delaitl/Synthetizer---Circuit-Architecture/Rapport.pdf

# LELEC1101 Rapport Final Synthétiseur - Casque Anti-Bruit

Groupe 31 - Delait L, Delcoigne B, Dufromont C, Letor M.

Mai 2019

## Contents

1 Introduction | 4
2 Vue d’ensemble du circuit | 4
3 Spécifications | 5
I | Synthétiseur | 5
4 Clavier | 5
4.3 Equations et dimensionnement | ´ | 6
4.4.2 | Equation | ´ | 7
5 Oscillateur contrôlé en tension (OCT) | 8
6 Conformateur à diodes | 13
6.3 Equations | ´ | 14
II | Noise-cancelling | 16
7 Introduction | 16
8 Micro filtre passe-haut | 17
9 Amplificateur variable | 17
9.2 Equations | ´ | 18
10 Filtre passe-tout | 18

11 Sommateur | 21
12 Suiveur | 22
III | Conclusion | 22
IV | Annexe | 24

## 1 Introduction

Dans le cadre du cours LELEC1101, les étudiants de deuscième bachelier en ingénieur civil ont été conviés à concevoir un synthétiseur et une unité d’annulation de bruit. L’Université Catholique de Louvain a mis les composants électroniques nécessaires à leur disposition. Notamment des résistances, capacités, amplificateurs opérationnels, comparateurs et des switches. Aucun autre composant n’était autorisé.
Le synthétiseur doit produire des sons correspondant à des notes de musique lors d’un appui sur ses touches. Dans notre implémentation, il est constitué d’un clavier, d’un oscillateur contrôlé en tension et d’un lisseur de signal. Le casque anti-bruit doit annuler les bruits parasites extérieurs. Il est constitué d’un micro, d’un filtre, d’un amplificateur et d’une unité de déphasage. Les deux signaux de sortie des deux unités doivent ensuite être additionnés pour alimenter le casque audio. Le produit final de notre projet est assez fidèle aux objectifs fixés. Le synthétiseur reproduit toutes les notes de deux octaves (LA3 → LA5) avec une imprécision moyenne de 4 Hz (0.5%) et maximum de 10Hz (1%). L’unité anti-bruit fonctionne comme attendu théoriquement: tous les signaux sont d’amplitude et de déphasage attendu. En pratique, lorsque le casque est branché, il est toutefois très difficile d’entendre une atténuation du bruit. Cela est dû à la difficulté de calibrage de l’implémentation.

## 2 Vue d’ensemble du circuit

La Figure 1 présente la décomposition en schémas blocs globalle. Le circuit est divisé en deux sous-circuits. Le premier se charge de la fonction synthétiseur alors que le second se charge de la réduction de bruit. Le synthétiseur est constitué d’un ensemble de boutons qui produisent un signal à tension continue. Ce dernier alimente un oscillateur contrôlé en tension (OCT) qui produit un signal triangulaire dont la fréquence dépend linéairement de la tension d’entrée. Le signal triangulaire est ensuite transformé en pseudo-sinusoïde afin de produire un son. L’unité anti-bruit est constituée d’un microphone dont le signal est d’abord filtré et amplifié. Ce filtrage est nécessaire car une composante continue est présente dans le signal capté par le microphone. Le signal filtré est enfin déphasé. Le déphasage est indispensable pour compenser le temps pris par le trajet du son sur la distance oreille-microphone. Les deux signaux sont ensuite additionnés et envoyés dans un casque audio.

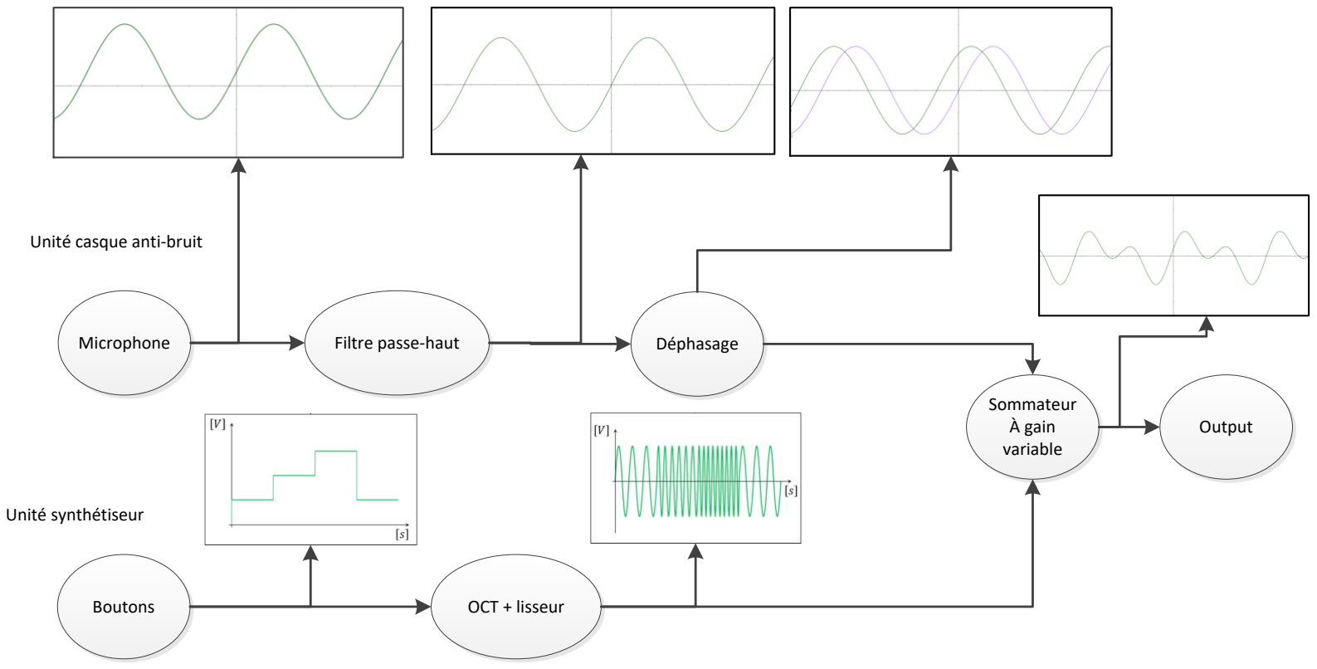
[picture p1: figure]
Microphone; Filtre passe-haut; Déphasage; Boutons; OCT + lisseur; Sommateur À gain variable; Output; Unité casque anti-bruit; Unité synthétiseur

Figure 1: Schéma bloc global du circuit

## 3 Spécifications

Contraintes
| Tensions d’alimentation de + et - 15V
| perturbation monochromatique
Choix synthétiseur
Nombre d’octaves couvertes | 2 (La 3 (440Hz) - La5 (1760 Hz))

2V
Effets sonores | Aucun
Pureté des notes | δfmoyen de 4 Hz (0.5%) δfmax de 10 Hz (1%)

Choix casque anti-bruit
Fréquence à laquelle l’annulation est maximale | 1000 Hz
Taux de réduction | indéterminé
Fonction du synthétiseur | f =

440
1.5

Vin heightAmplitude du son

## Part I

# Synthétiseur

Cette partie expose en détail l’implémentation choisie pour le synthétiseur. Il est composé d’un clavier qui prend pour entrée une tension continue et sort une tension différente selon la combinaison de touches pressées. Ce signal est introduit dans un oscillateur commandé en tension (OCT) produisant un signal triangulaire périodique de fréquence linéairement proportionnelle à la tension d’entrée. Le signal triangulaire est lissé par un conformateur à diodes qui le convertit en signal pseudo-sinusoïdal.

## 4 Clavier

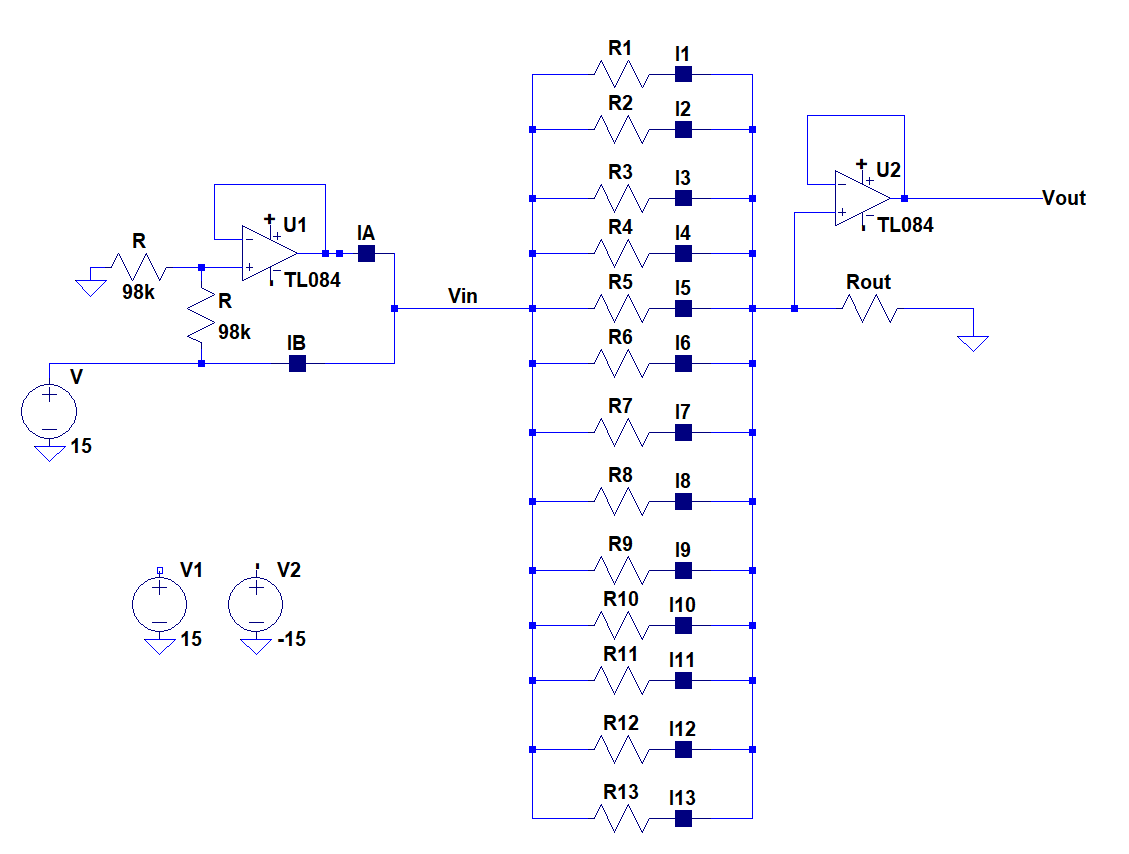
[picture p2: figure]

Figure 2: Montage Clavier - Ii est ici le diminutif de l’Interrupteur i

### 4.1 Description

Le clavier permet, selon la combinaison d’interrupteurs fermés, de produire une tension Vout allant de 1.5 à 3 V et de 3 à 6 V. Comme décrit sur la Figure 1, ce signal en tension continue alimente ensuite l’oscillateur contrôlé en tension qui produit un signal dont la fréquence lui est directement proportionnelle.

### 4.2 Fonctionnement

Le clavier fonctionne sur base d’un double diviseur résistif : le premier permet d’avoir une tension d’entrée (Vin) de 7.5V ou 15V (selon si IA ou IB est fermé) et le second permet de modifier la valeur des résistances Ri
, et donc
la tension Vout (en fermant un des interrupteurs Ii), i ∈ [1, 13].

### 4.3 Equations et dimensionnement ´

Sur base du dimensionnement de l’OCT, la tension minimale Vout doit être de 1.5V et correspondre à un LA3 (440Hz). La relation tension-fréquence étant linéaire, LA4 (880Hz) ↔ 3V et LA5 (1760Hz) ↔ 6V.
La tension de sortie du clavier (Vout) ne dépasse pas 6V pour être sûr de rester dans la zone de comportement idéal de l’ampli op.
25 notes doivent pouvoir être jouées par le synthétiseur et donc 25 tensions produites en Vout.
Ce bloc étant un diviseur résistif (avec 2 montages suiveurs dont la présence sera justifiée par la suite), l’équation qui le caractérise est la suivante :

Vout =

Vin(IA, IB) · Rout

Ri(Ii) + Rout

(1)

Avec i ∈ [1, 13].

On peut donc jouer sur 2 paramètres d’un côté et 13 de l’autre ce qui fait 26 tensions en Vout possibles et donc 26 notes potentielles.
Le synthétiseur doit être capable de produire 25 notes du LA3 au LA5 selon nos spécifications. Sur base de la relation LA4 (880Hz) ↔ 3V et en sachant que la relation Vout-fréquence est linéaire, connaissant les fréquences voulues, on peut déterminer les tensions Vout en sortie du clavier.

Le LA4 peut être joué de 2 manières différentes par les combinaisons (iA, i13) ou (iB, i1) qui produisent toutes les 2 une tension de 5V:
De là, connaissant Vout, il ne reste qu’à déterminer les valeurs des résistances Rout et Ri
La valeur de Rout a été imposée à 362Ω, et de là se calculent les valeurs de la Figure 3

Figure 3: Tableau valeurs résistances

Finalement, la Figure 4 donne la tension Vout à la sortie du clavier ainsi que la note correspondante à la sortie de l’OCT selon la combinaison d’interrupteurs actionnés.

### 4.4 Les deux montages suiveurs

### 4.4.1 Description et Fonction

L’introduction d’un montage suiveur U1 se justifie par le fait qu’un simple diviseur de tension provoque une chute de tension en Vin lorsqu’on active un des interrupteurs Ii

, le courant étant trop faible pour maintenir la tension à 7.5V.
De la même façon, le montage suiveur U2 fut implémenté car le courant en sortie du clavier est trop faible en entrant dans l’OCT, une chute de tension apparaissant à cet endroit.

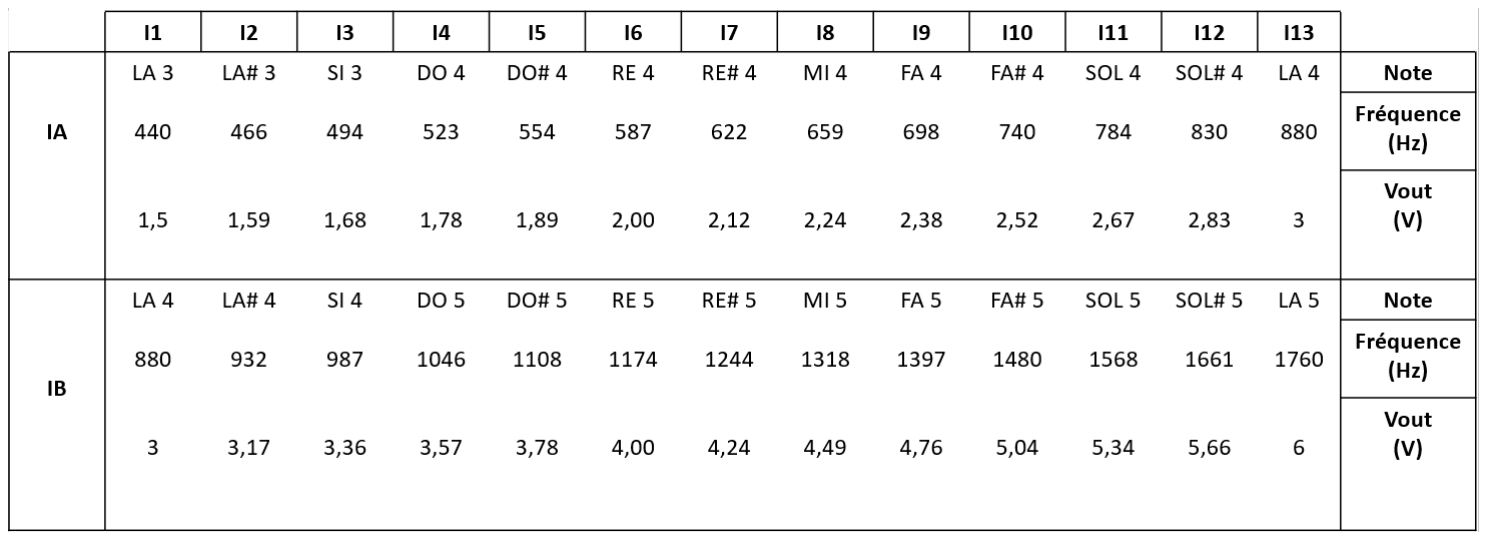
[picture p3: figure]

Figure 4: Tableau interrupteurs-tension-note

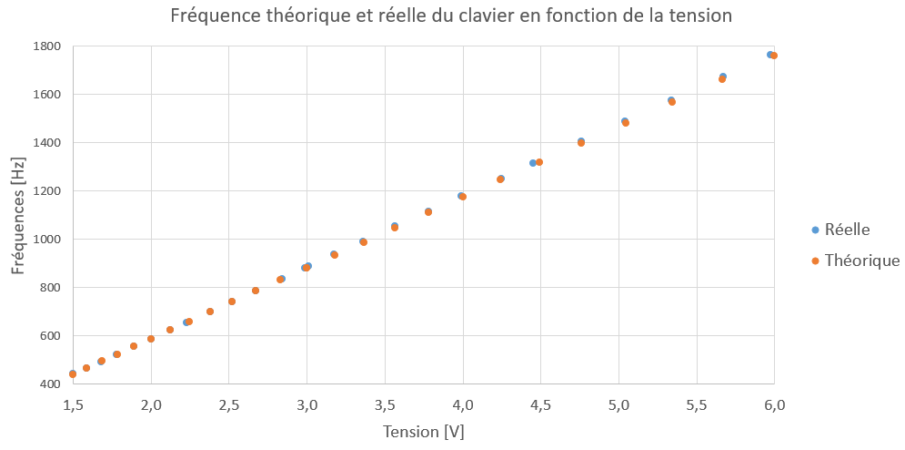
[picture p4: figure]

Figure 5: Graphe fréquence-tension

### 4.4.2 Equation ´

Dans la zone de comportement idéal de l’ampli op l’équation qui les caractérise est :

Vout = Vin

### 4.5 Résultats expérimentaux et comparaison

On observe sur la Figure 5 un léger décalage entre les fréquences souhaitées et les fréquences réellement obtenues (δfmax de 10Hz, δfmoyen de 3.5Hz). Cette différence peut être expliquée car les tensions en sortie de l’OCT ne sont pas parfaitement égales aux valeurs souhaitées(δVmax de 43mV, δVmoyen de 7mV).
Cette différence minime de tension peut elle-même s’expliquer par le fait qu’il y ait une différence entre les valeurs des résistances voulues et les valeurs réelles du circuit (δRmax de 14 Ω, δRmoyen de 5 Ω).
Toutes les résistances sont des potentiomètres qu’il a fallu régler manuellement, les valeurs de résistances nécessaires n’étant évidemment pas disponibles telles quelles, de par leur valeur très spécifique. Les erreurs sont donc causées par le degré de précision mécanique des potentiomètres.
Toutes les valeurs des mesures sont disponibles en Annexe.

### 4.6 Pistes d’amélioration

Il serait opportun d’imaginer un troisième interrupteur IC en lien avec la source et un diviseur de tension tel que Vin = 0.75V . De fait, et par le même raisonnement qu’explicité ci-dessus, on pourrait couvrir les notes du LA2 au LA3 et ainsi de suite avec un quatrième interrupteur tel que Vin = 0.375V . Cela nécessiterait des valeurs de plus en plus précises pour les résistances utilisées (et donc des imprécisions grandissantes) et permettrait de couvrir toutes les notes plus basses que LA3.

## 5 Oscillateur contrôlé en tension (OCT)

### 5.1 Fonctionnement et description

L’oscillateur commandé en tension se base sur un principe de rétroaction. La spécification donnée est qu’une tension continue est donnée en entrée afin de générer un signal triangulaire périodique. Le système conçu est le suivant: soit la tension continue entre telle quelle dans le circuit, soit elle est inversée. Ce signal continu positif ou négatif entre dans un montage ampli-op intégrateur produisant une pente montante, ou descendante. Ce signal linéaire croissant ou décroissant commande une bascule à hystérèse qui active un interrupteur lorsque la tension atteint un certain seuil, et le désactive seulement lorsqu’un autre seuil est atteint. Cet interrupteur a un effet sur la tension d’entrée qui est inversée ou non. Un signal triangulaire apparaît en coordonnant correctement ces trois éléments.

### 5.2 Décomposition par blocs

Cette section détaille chaque bloc composant l’oscillateur contrôlé en tension. Les variables utilisées, ainsi que le circuit implémenté se trouvant en Figure 6.

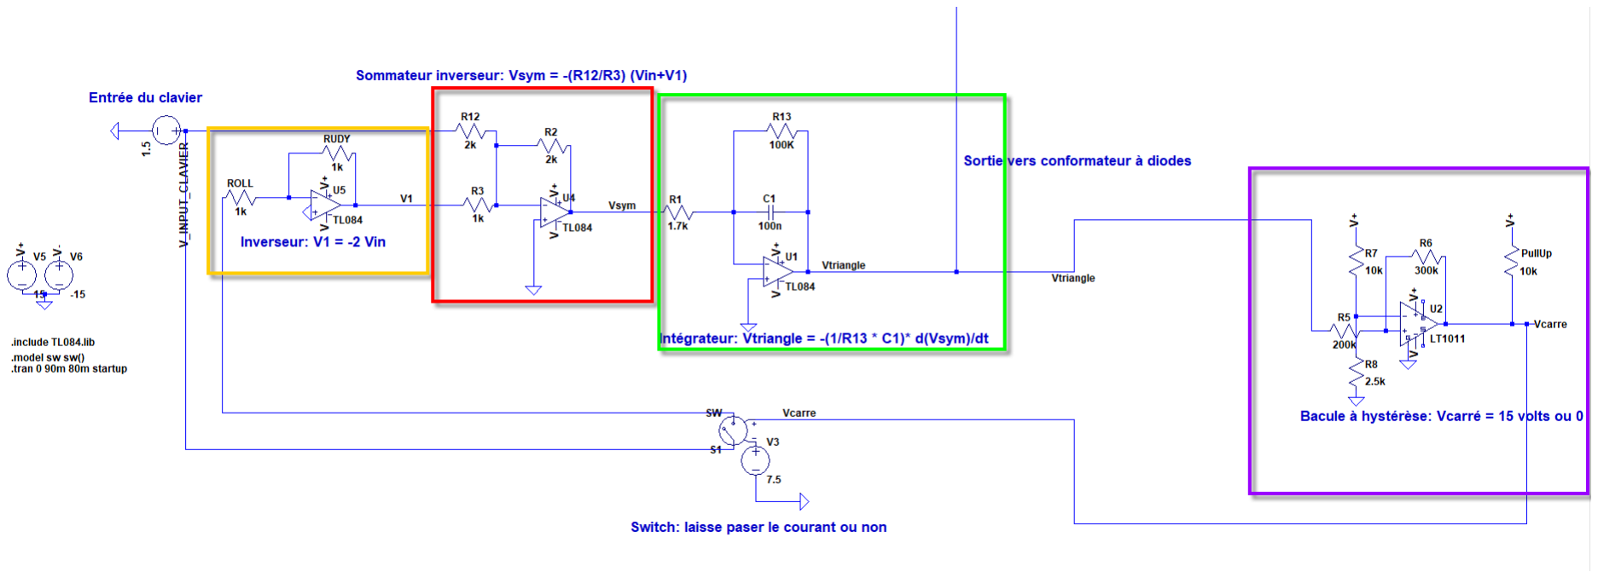
[picture p5: figure]

Figure 6: Circuit de l’oscillateur controlé en tension

### 5.2.1 Inverseur

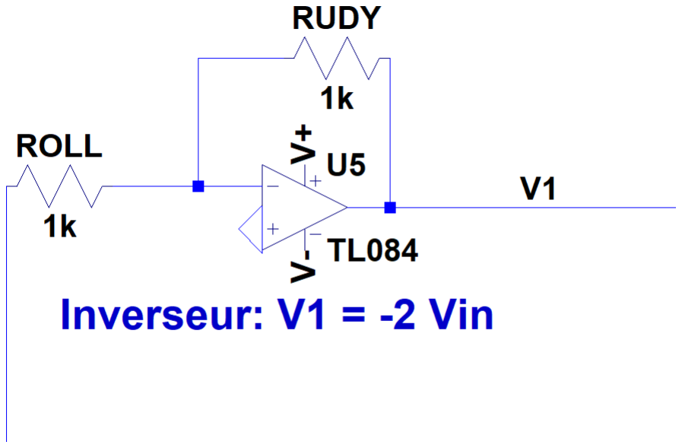
[picture p6: figure]

Figure 7: Schéma de l’inverseur

Description La Figure 7 présente le schéma de l’inverseur. L’inverseur prend pour tension d’entrée la tension sortant du clavier, ou bien une tension nulle, dépendant de l’état du switch. L’objectif est d’en ressortir la tension inverse.

Equations Par la loi des noeuds,

V1 = −(

Rudy
Roll ) · Vin | (2)

Choix des composants L’objectif du bloc est d’obtenir une tension de sortie

V1 = −Vin

Vin. Le rapport des résistances Rudy
Roll doit donc être unitaire. Nous avons choisi des résistances de même valeur.

### 5.2.2 Sommateur inverseur

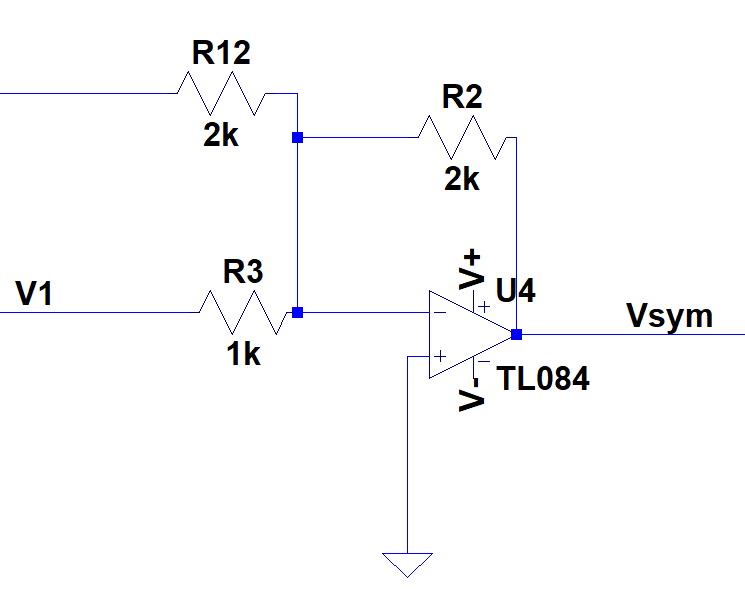
[picture p7: figure]

Figure 8: Schéma de sommateur inverseur

Description La Figure 8 présente le schéma du bloc sommateur. Le sommateur prend pour tension d’entrée la tension générée par le clavier, ainsi que la tension sortant de l’inverseur. L’objectif visé est d’obtenir selon l’état d’un switch la tension d’entrée du clavier, ou son inverse. Cet objectif est atteint facilement avec un sommateur inverseur qui somme soit uniquement le signal sortant du clavier, soit le signal du clavier additionné de son inverse avec un rapport de 2.

Equations ´ | Par Kirchhoff:
Vsym = −R2( Vin
R12

+

V 1
R3
) | (3)

Choix des composants Lorsque le switch laisse passer le courant, le sommateur inverseur reçoit deux entrées: Vin et V 1. L’objectif est d’obtenir Vin en sortie. Par la relation 3, Vsym = Vin si R2 = R12 et 2 R3 = R2. Lorsque le switch ne laisse pas passer le courant, le sommateur inverseur inverse uniquement Vin avec un rapport unitaire. Selon l’état du switch, la sortie est bien la tension d’entrée inversée ou non.

### 5.2.3 Intégrateur

Description La Figure 9 présente le schéma de l’intégrateur à perte.L’objectif du bloc intégrateur est d’obtenir en sortie un signal triangulaire symétrique. En intégrant une tension continue positive, on obtient une tension linéairement croissante en sortie. Pour une tension d’entrée négative, la sortie est décroissante. La tension d’entrée est positive ou négative suivant l’état du switch. Cette sortie sera symétrique uniquement si la période durant laquelle la pente est décroissante est aussi longue que lorsqu’elle est croissante. Autrement dit, si la tension d’entrée est positive durant un laps de temps, elle doit être négative durant le même laps de temps. La bascule à hystérèse a pour rôle d’actionner le switch au bon moment pour coordonner cette tâche.

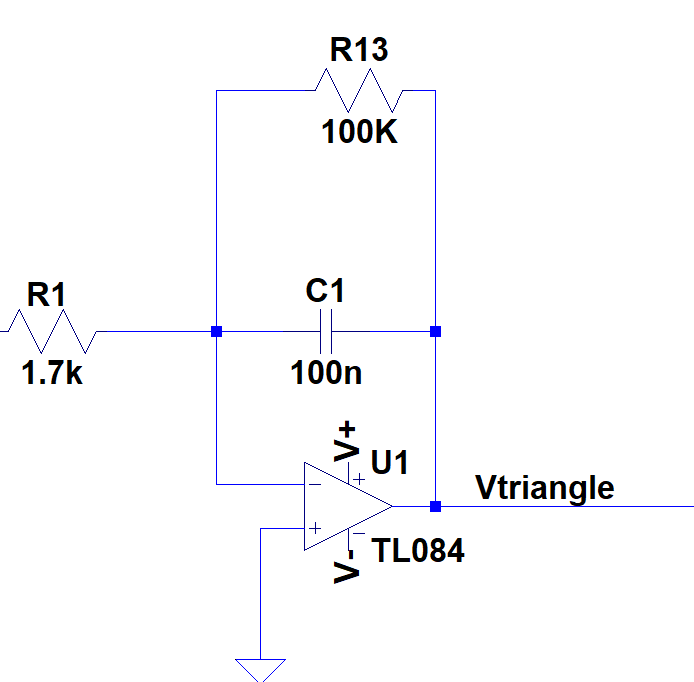
[picture p8: figure]

Figure 9: Schéma de l’intégrateur

Equations ´ | La tension de sortie de l’intégrateur peut à nouveau être exprimée par la loi des noeuds:

Vtriangle =

−1
R13 · C1

Z
Vsymdt | (4)

Le gain est donné par
−R1
R13

(

1
1 + R13jωC1
) | (5)

La fréquence de coupure est donnée par 1
2πR13C1

(6)

Choix des composants Le choix de la résistance et de la capacité influence directement sur la fréquence de l’OCT.
Il est donc primordial d’exprimer la fréquence en fonction de la tension d’entrée.

L’équation 4 de l’intégrateur nous permet de calculer la pente du signal triangulaire:

dVtriangle
dt =

−1
R13 · C1
Vsym | (7)

Le bloc suivant, la bascule à hystérèse, fait en sorte que le signal triangulaire reste borné entre la tension de bascule haute et basse. Cela signifie que sur une demi-période, la tension passe linéairement du seuil haut au seuil bas. Seuil haut étant fixé à 5V, et bas à -5V. Sur une demi-période, le delta de tension est de 10V

2 · 10V
T

(8)

En combinant les équations (7) et (8), 1
T

=

Vsym
20 · R13 · C1

(9)

Avant de déterminer R et C, il est impératif d’associer une tension à une fréquence. Nous avons choisi une fréquence de 440Hz lorsque Vin= 1.5V. Comme la fréquence dépend linéairement de la tension d’entrée (9), à 3V nous aurons 880Hz, et à 6V 1760Hz. Avec l’équation 9, en remplaçant la fréquence par 440Hz et la tension par 1.5V, nous trouvons
R13 · C1 = 1.704 · 10⁻⁴

Une capacité de 100nF a été choisie, ainsi qu’un potentiomètre de 2kΩ réglé à 1.7 kΩ La résistance R13 a été choisie telle que la fréquence de coupure soit d’environ 20Hz afin de se situer dans le comportement intégrateur (voir Figure
10) de l’ampli-op dans nos fréquences générées. Une résistance de 100K donne une fréquence de coupure de 16Hz par l’équation (6). C’est bien ce qu’on peut observer dans le Figure 10.

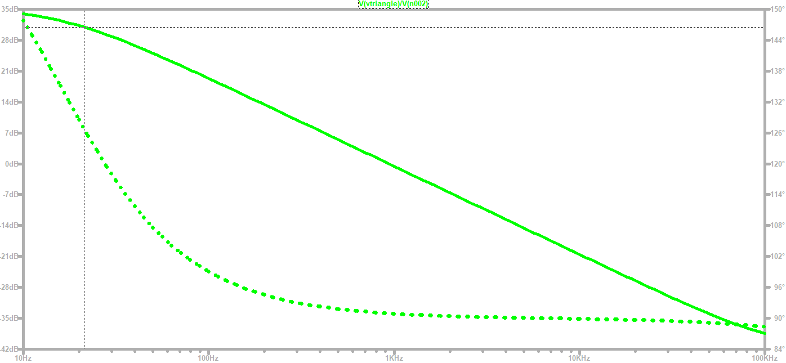
[picture p9: figure]

Figure 10: Diagramme de bode de l’intégrateur (simulation)

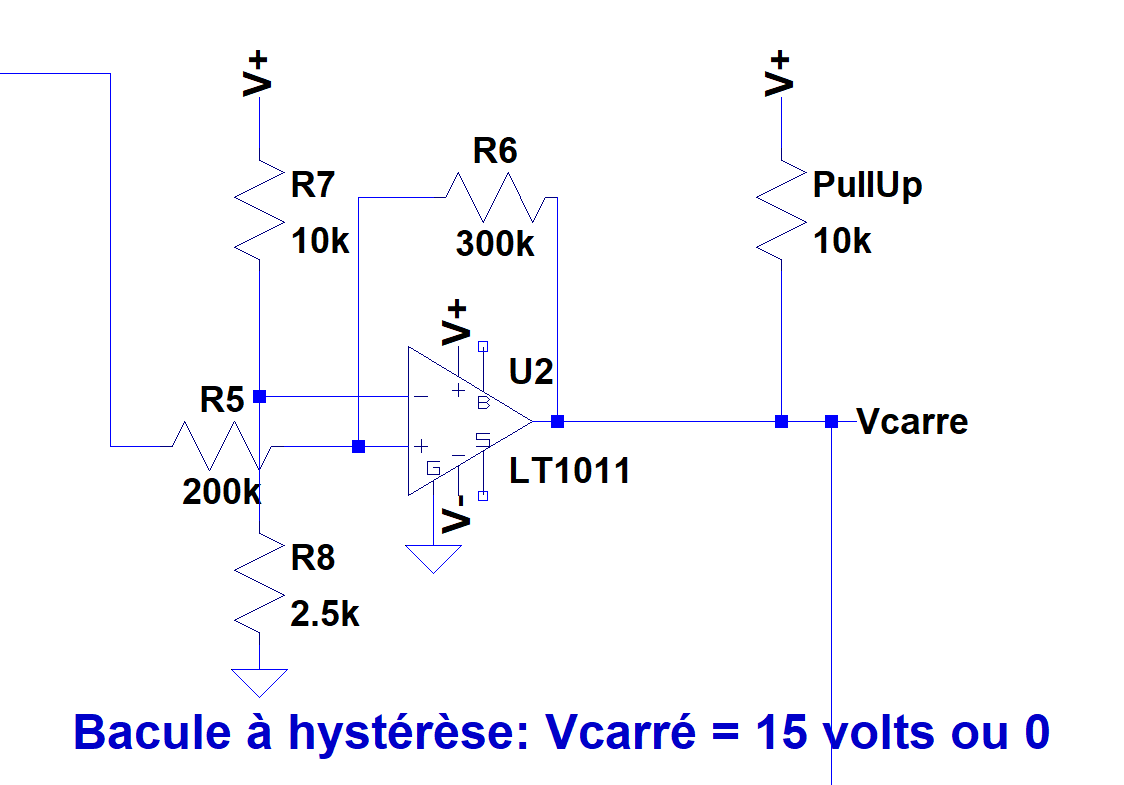
[picture p10: figure]

Figure 11: Schéma de la bascule à hystérèse

### 5.2.4 Bascule à hystérèse

Description La Figure 11 présente le schéma de la bascule à hystérèse. Le rôle de la bascule à hystérèse est d’actionner l’interrupteur de rétroaction au bon moment (voir intégrateur). L’interrupteur est commandé en tension: il s’ouvre lorsqu’une tension de 15V lui est donnée en entrée, et se ferme avec une tension nulle. Par conséquent, la spécification donnée au bloc bascule à hystérèse est de générer une tension continue de 15V lorsqu’un seuil haut a été atteint, et une tension nulle lorsqu’un seuil bas a été atteint. Les seuils haut et bas ont été fixés à +5V et -5V. Il est impératif que la valeur absolue des seuils soit identique afin d’avoir un signal triangulaire symétrique.
Le signal sortant de l’intégrateur entre dans la bascule à hystérèse. Initialement, ce signal est décroissant. Lorsque le seuil de -5V est atteint, la bascule actionne le switch, ce qui a pour effet d’inverser la tension entrante dans l’intégrateur et par conséquent de produire un signal linéaire croissant. Lorsque ce signal atteint le seuil de 5V, le switch change à nouveau d’état et donc le signal décroît à nouveau. Ce mécanisme nous fournit donc un signal triangulaire périodique.

Equations Les équations (10) et (11) donnent les valeurs des seuils haut et bas de la bascule à hystérèse. Vref est la tension à la borne négative de l’amplificateur opérationnel. Nous pouvons la fixer avec le pont résistif formé de R7 et R8.
Vh = VREF · (1 + R5
R6
) | (10)

Vb = VREF +

R5
R6
- (Vref − VDD) | (11)

La spécification du bloc est que le seuil haut, Vh soit égal à 5V, et Vb à -5V. En résolvant le système d’équations, sachant que VDD = 15V, nous trouvons:

Vref = 3V

R6
R5

=

3
2

Choix des composants VRef est générée par un simple diviseur résistif constitué d’un potentiomètre de 10kΩ. Pour effectuer nos calculs nous avons utilisé la condition de simplification: 1kΩ < Rpullup << R6. Rpullup, la résistance pullup est une résistance de 10kΩ. R6 doit donc lui être bien supérieure. Pour le rapport R5/R6, un potentiomètre de 400kΩ a donc été choisi.

### 5.3 Comparaison

Afin de vérifier la cohérence des calculs et simulation, il est important de comparer les signaux obtenus aux différents endroits de l’OCT. Cette section reprend les signaux d’entrée et de sortie de chaque bloc, en simulation et en réalité.

Sortie du sommateur Selon les équations, la sortie du sommateur présente un signal périodique carré symétrique. Avec une tension haute égale à l’inverse de la tension basse. La Figure 12 montre la tension en sortie du sommateur dans nos simulations LTSPICE, alors que la Figure 13 montre la tension dans le circuit implémenté. Les signaux simulés sont symétriques comme prévu par les équations. Les signaux réels semblent être symétriques aussi. L’erreur est trop petite pour être mesurée.

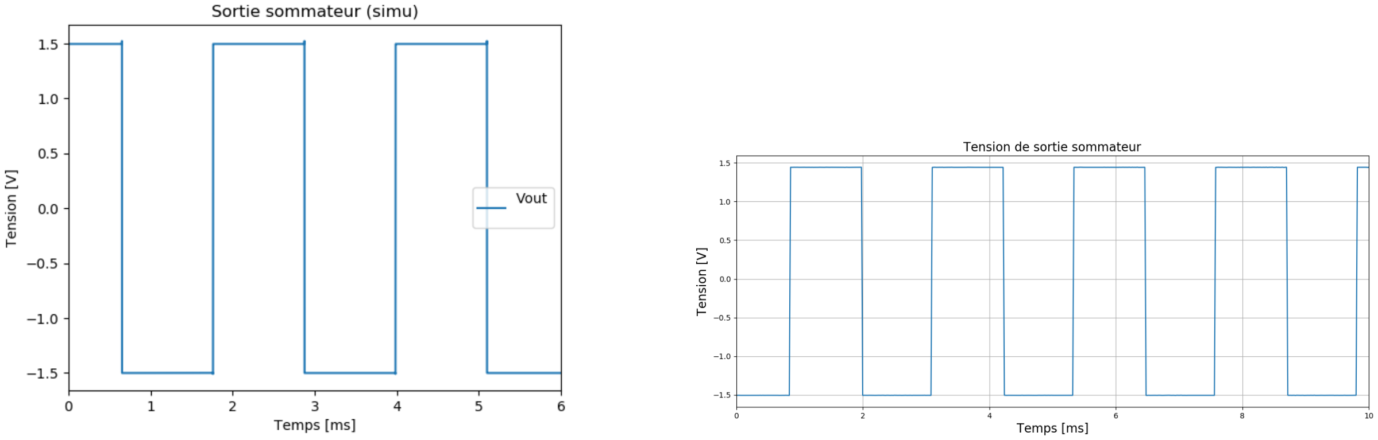
[picture p11: figure]

Figure 12: Signal en sortie sdu sommateur(simulation)

Figure 13: Sortie du sommateur inverseur(MyDaq)

Sortie de l’intégrateur Le signal triangulaire sortant de l’intégrateur doit en théorie être borné entre -5 et 5V. Cela se justifie par le fait que la bascule à hystérèse agit théoriquement à -5V et 5V pour inverser la pente de l’intégrale. La Figure 14 montre le signal simulé sortant de l’intégrateur et la Figure 15 montre ce même signal dans le circuit implémenté. En simulation comme en réalité, la tension d’entrée est de 1.5V, ce qui correspond théoriquement à une fréquence de 440Hz, donc une période de 2.2ms. C’est bien ce qu’on peut observer sur les deux figures.

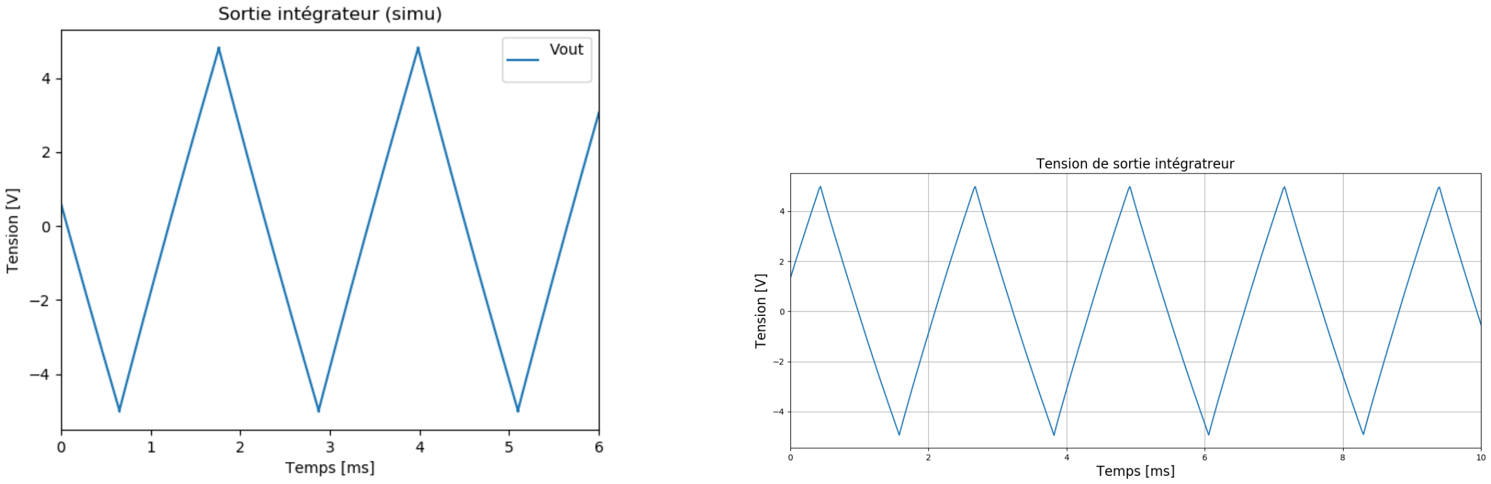
[picture p12: figure]

Figure 14: Signal en sortie de l’intégrateur (simulation)

Figure 15: Signal en sortie de l’intégrateur(MyDaq)

Bascule à hystérèse Le paramètre important à analyser dans la bascule à hystérèse est la tension seuil. La Figure 16 montre en simulation le signal entrant et sortant de la bascule. Nous observons bien que la bascule s’actionne à -5 et 5V en simulation. Malheureusement, le MyDaq ne nous permet pas de faire un graphe de la tension de la bascule. En effet, la tension varie entre 0 et 15V alors que le MyDaq sature à 10.66V. A l’oscilloscope ` nous avons remarqué que le signal, quelle que soit la fréquence, a une amplitude de 15V.

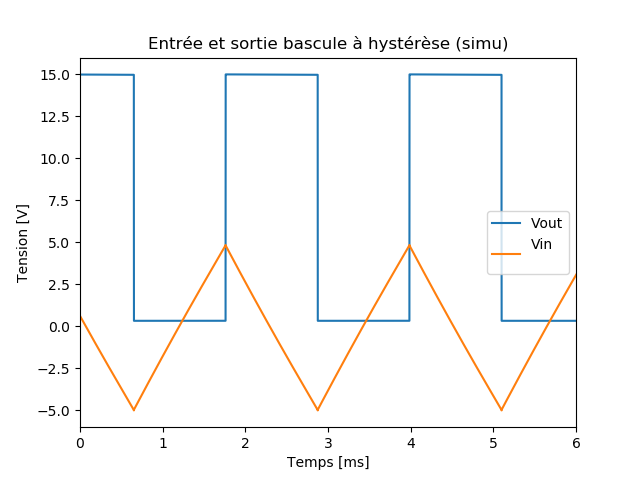
[picture p13: figure]

Figure 16: Signal entrant et sortant de la bascule à hystérèse (simulation)

## 6 Conformateur à diodes

### 6.1 Description

Ce bloc prend en entrée le signal triangle de l’intégrateur et l’interpole en un sinus plus doux à l’oreille. Le choix du conformateur à diodes pour effectuer cette tâche se justifie pour plusieurs raisons. Les fréquences auxquelles nous travaillons varient entre 440 Hz et 1760 Hz or le conformateur est insensible à la fréquence. Cependant il requiert une amplitude constante ce qui est bien notre cas (5 V).

### 6.2 Fonctionnement

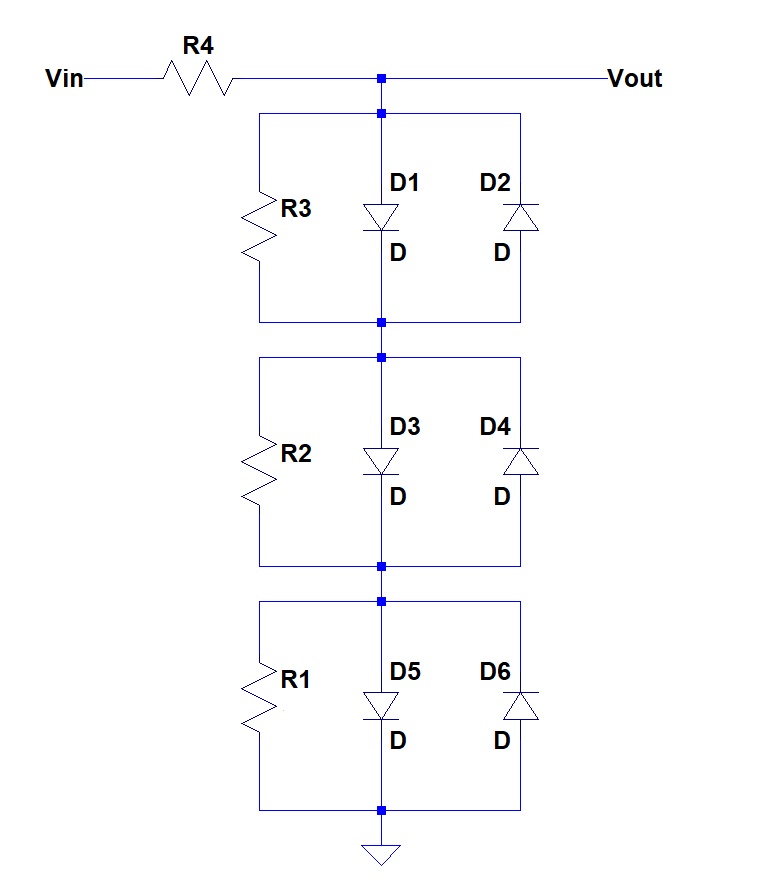
[picture p14: figure]

Figure 17: Schéma du conformateur à diodes

Le conformateur fonctionne comme un diviseur résistif qui change de valeur en fonction de la tension d’entrée (Figure 17). Ce système se base sur la non-idéalité des diodes qui ne s’activent qu’à partir de 0.6 V. Le sinus est donc interpolé en segments de droites comme montré sur la Figure 18.

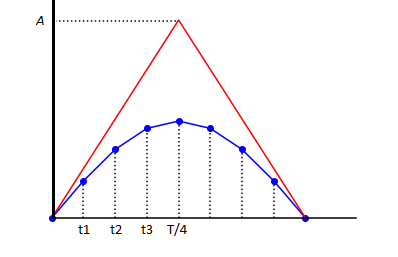
[picture p15: figure]

Figure 18: Fonctionnement du conformateur à diodes

### 6.3 Equations ´

La tension de sortie du conformateur varie en fonction du nombre de diodes passantes. Ainsi, lorsqu’aucune diode ne laisse passer le courant(entre 0 et t1), le conformateur agit comme un diviseur de tension entre R4 et les autres résistances. De ce fait la tension de sortie s’exprime:

Vs =

R1 + R2 + R3
R1 + R2 + R3 + R4

Ve

A l’instant ` | t1,la diode D5 devient passante,ce qui signifie que la tension aux bornes du premier étage (qui est égale
à la tension aux bornes de R1) vaut 0.6 V:
| Ve(t1).R1 (R1 + R2 + R3 + R4) = 0.6V

Une fois que les diodes sont passantes, elles se comportent comme des sources de tension DC de 0.6 V. Nous pouvons donc trouver trois autres équations décrivant le conformateur en fonction de la tension d’entrée:
| Entre t1 et t2: Vs(t) = 0.6 + (Ve(t) − 0.6).(R2 + R3) R2 + R3 + R4

Entre t2 et t3:
| Vs(t) = 1.2 + (Ve(t) − 1.2).R3 R3 + R4

Entre t3 et T /4:
| Vs(t) = 1.8 + Ve(t) − 1.8 R4

Les tensions négatives sont obtenues de la même façon avec les diodes disposées dans l’autre sens.

### 6.4 Choix des composants

Le choix des résistances s’effectue en fait en fonction du choix des abscisses où sera interpolé le sinus. Ce choix d’abscisses doit en effet permettre de minimiser les contributions des harmoniques dans le signal pour avoir un sinus le plus pur possible.
| Nous avons décidé de prendre des intervalles proportionnels à la pente du sinus, et non équidistants car le sinus
est assez linéaire au début puis devient de plus en plus courbe.
| Prenons un sinus d’amplitude 1 et de période 2π (cela simplifie les calculs mais ne change pas les résultats)
et calculons les fractions de période. Nous savons que la pente de sin(t) est décrite par cos(t) et qu’elle varie de 1 à 0 entre 0 et T/4(=π/2 ici). Nous séparons donc l’intervalle de pente en 4 et égalons ces temps aux pentes correspondantes:
| (cos(0) = 1), cos(x1) = 0.75, cos(x2) = 0.5, cos(x3) = 0.25 Ce qui nous donne nos abscisses qu’il faut encore diviser par 2π afin d’obtenir des fractions de période. On

obtient t1 ' 0.115T, t2 = T /6 ' 0.167T et t3 ' 0.21T.Le sinus interpolé avec de telles abscisses est représenté à la figure 19.
| Une fois ces abscisses calculées, les résistances découlent des équations aux différents points d’interpolation à
savoir:

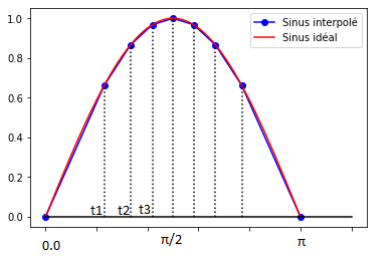
[picture p16: figure]

Figure 19: Sinus interpolé aux abscisses optimisées

En t1:
0.6 =

Ve(t1).R1
R1 + R2 + R3 + R4
En t2:
0.6 =

(Ve(t2) − 0, 6).R2
R2 + R3 + R4
En t3:
0.6 =

(Ve(t3) − 1, 2).R3
R3 + R4
Nous disposons donc de 3 équations à 4 inconnues. Nous avons décidé arbitrairement de fixer R4 à 1.8 kΩ. En résolvant ensuite le système et en tenant compte que le signal triangle d’entrée varie entre -5v et 5V, nous obtenons R1 = 450 Ω, R2=633Ω et R3=1 017Ω.

### 6.5 Comparaison

La théorie nous dit que le sinus sera interpolé en segments de droite. Cependant, les diodes ne sont pas idéales et les points anguleux sont lissés. Ce comportement est pris en compte par LTSpice dans les simulations. La comparaison entre la simulation et les valeurs observées au MyDaq peut être observée aux Figures 20) et 21. On peut voir que les graphes sont très similaires au niveau de la forme et donc que les simulations se rapprochent très bien de la réalité.

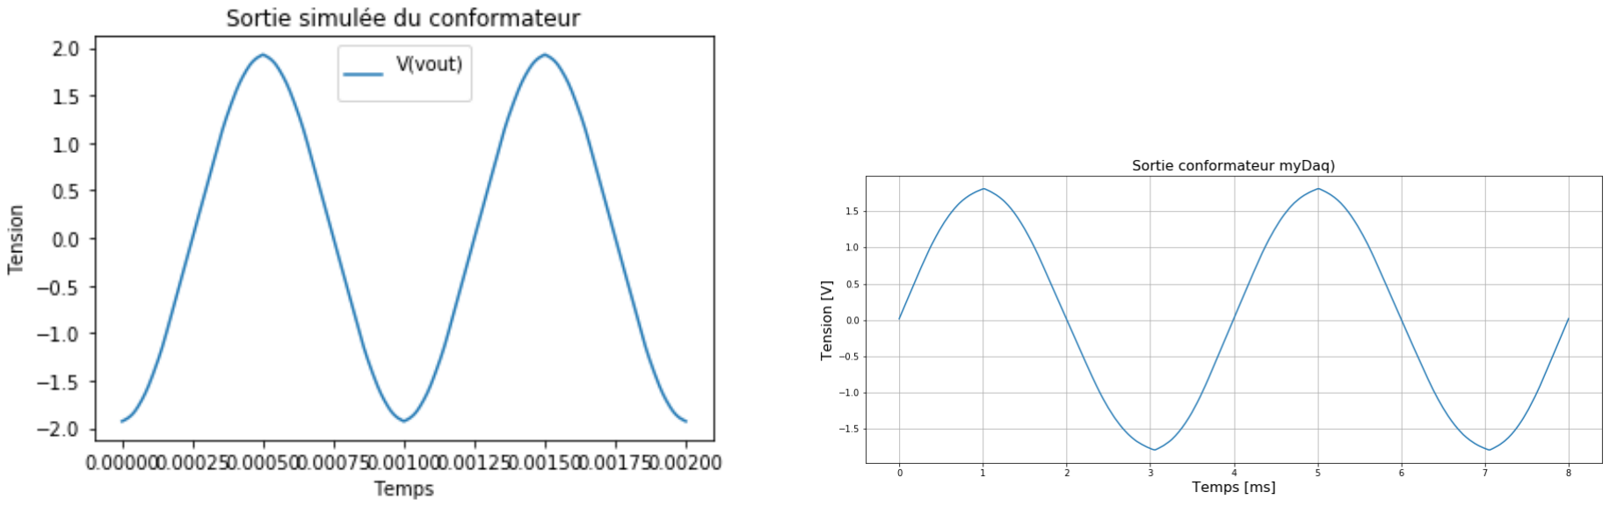
[picture p17: figure]

Figure 20: Sortie du conformateur sur LT-Spice

Figure 21: Sortie du conformateur au MyDaq

De plus, les simulations montraient que le conformateur interpolait le sinus de la même manière quelle que soit la fréquence. Des tests au laboratoire nous ont confirmé ce comportement, nous n’avons donc pas à nous soucier d’une éventuelle déformation quelle que soit la note jouée.

### 6.6 Résultat

La qualité d’un sinus s’observe en consultant son contenu spectral. Sur le spectre obtenu en simulation (Figure 22 à 1000 Hz), nous pouvons voir la fondamentale à 1kHz ainsi que la première harmonique à 3kHz qui est déjà très atténuée(-32dB). Toutes les harmoniques suivantes sont atténuées en deçà de cette valeur. Le spectre obtenu en laboratoire est similaire bien que l’on puisse constater une moindre atténuation des harmoniques. Cela peut s’expliquer par le fait que les résistances calculées ont des valeurs spécifiques que nous avons réalisées avec des potentiomètres moins précis que dans la simulation.

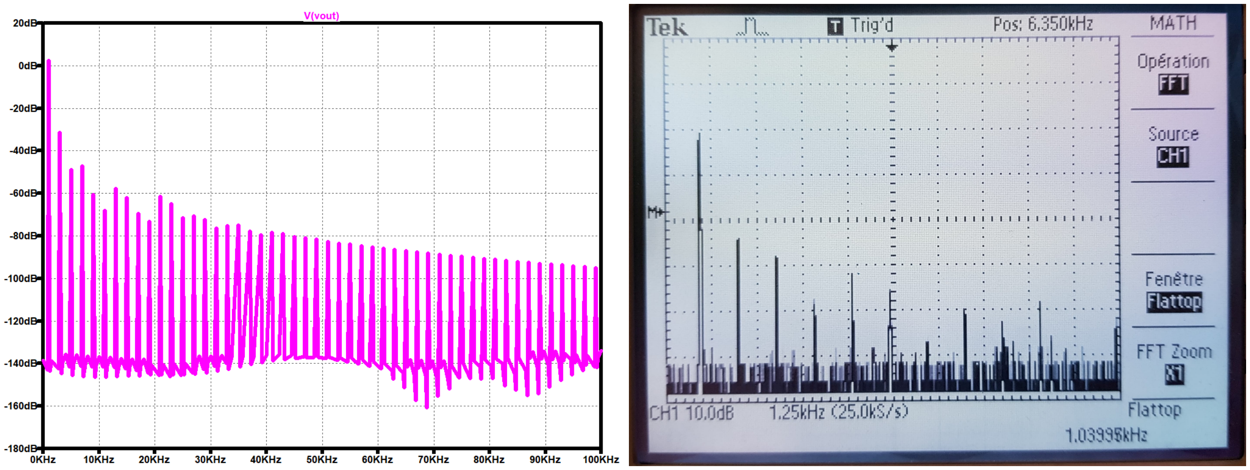
[picture p18: figure]

Figure 22: Spectre de sortie du conformateur sur LTSpice Figure 23: Spectre de sortie du conformateur à l’oscilloscope

## Part II

# Noise-cancelling

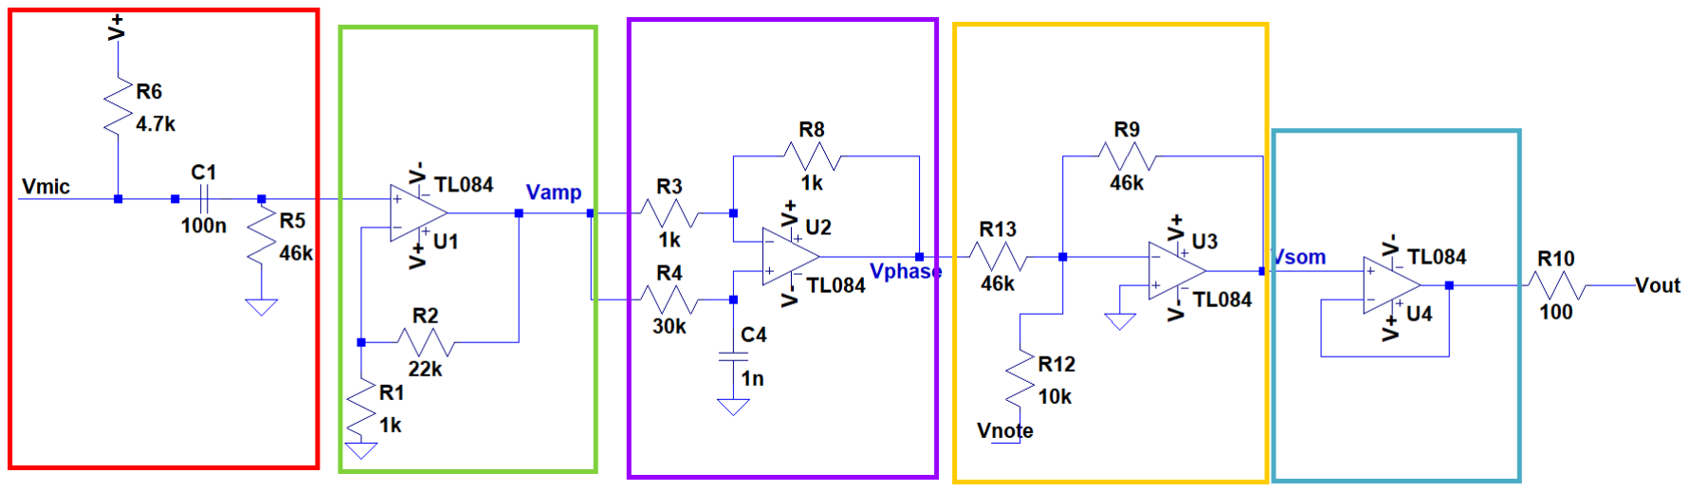
[picture p19: figure]

Figure 24: Circuit anti-bruit

## 7 Introduction

Ce circuit (figure 24) capte un signal en entrée grâce au micro, amplifie ce signal, le déphase pour ensuite l’additionner au signal de sortie du conformateur. Cette addition est faite par le sommateur inverseur qui permet également d’inverser le signal.
Le signal ainsi renvoyé agit en interférence destructive avec les sons ambiants et supprime une partie d’entre eux pour permettre à l’utilisateur d’entendre plus clairement les notes émises par le synthétiseur.

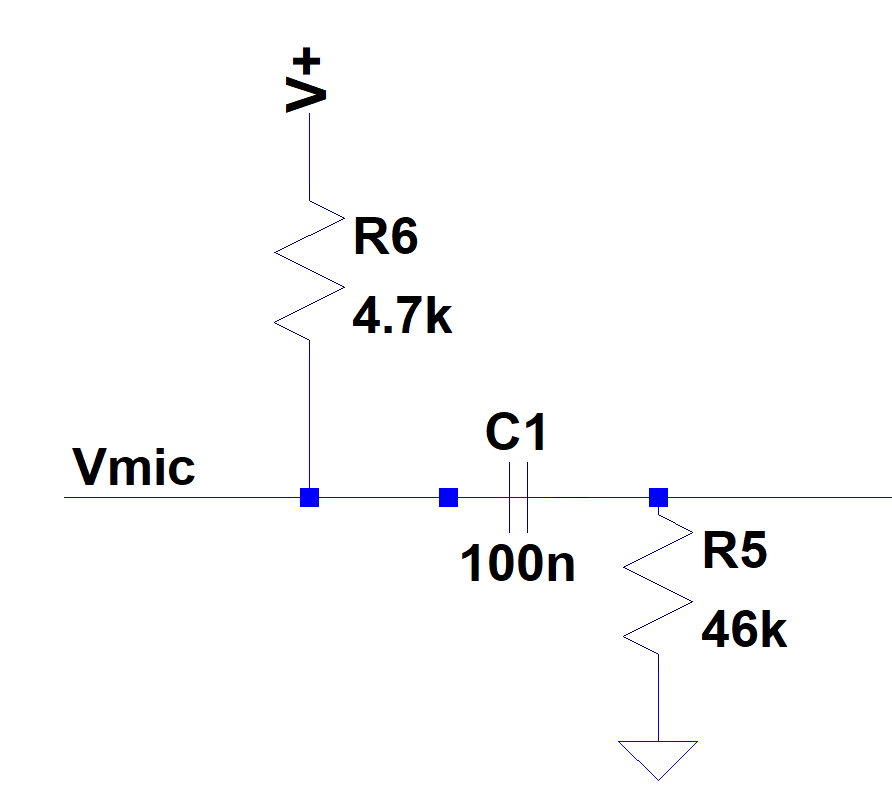
[picture p20: figure]

Figure 25: Circuit micro filtre passe-haut

## 8 Micro filtre passe-haut

### 8.1 Description

Le but du micro est de capter le son extérieur que nous voulons annuler. Ce son, comme précisé dans les spécifications, est monochromatique.

### 8.2 Entrée-sortie

Entrée : onde sonore monochromatique
Sortie : Tension sinusoïdale dont l’amplitude est de l’ordre de la dizaine ou la centaine de millivolts.

### 8.3 Choix des composants

La capacité et la résistance jouent un rôle de filtre passe-haut, ce filtre permet de supprimer la composante DC du signal de sortie du micro. Pour que le filtre ait ce comportement, il faut que sa fréquence de coupure soit assez basse (¡100Hz). Nous avons alors pris une fréquence de 35Hz et par la relation 12 on trouve
R5 = 46kΩ et C1 = 100nF
L’autre résistance (R2) joue quant à elle un rôle dans l’alimentation du transistor du micro.

RC =

1
2πfc

(12)

## 9 Amplificateur variable

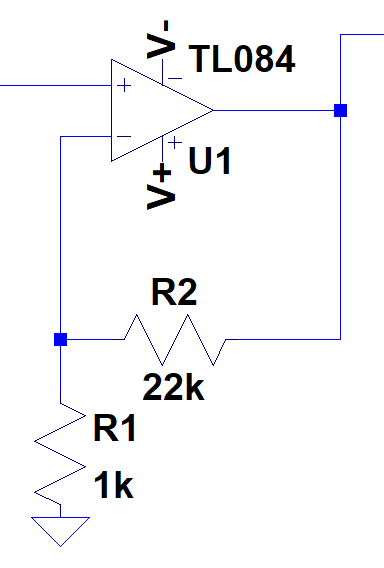
[picture p21: figure]

Figure 26: Circuit amplificateur

### 9.1 Description

Le circuit de la figure 26 est un amplificateur non-inverseur avec un gain variable grâce à un potentiomètre (représenté par R1 et R2 sur la Figure 26). En utilisation, son gain est d’environ 10 (tension du micro de l’orde de

100mV) à 100 (tension micro de l’orde de 10mV).

### 9.2 Equations ´

Vout = Vin ∗ (

R2
R1
+ 1) | (13)

## 10 Filtre passe-tout

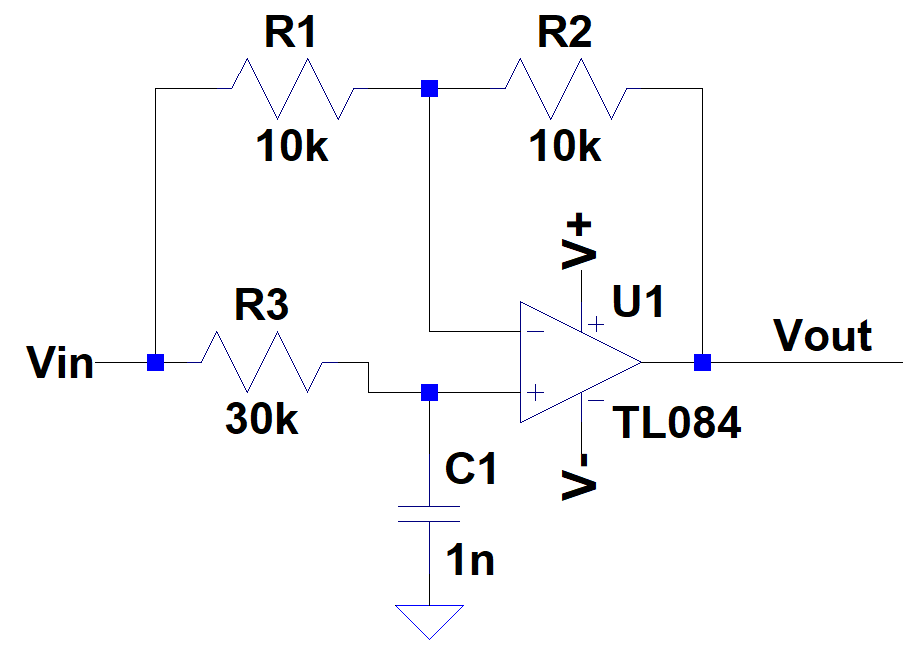
[picture p22: figure]

Figure 27: Filtre passe-tout

### 10.1 Description

L’objectif de ce bloc (figure 27) est d’effectuer un déphasage entre les signaux d’entrée (Vin) et de sortie(Vout). Ce déphasage permet de compenser le décalage temporel dû à la distance entre le micro et l’oreillette. Sans ce bloc le son envoyé au casque serait en avance par rapport au son arrivant à l’oreille, empêchant donc une annulation complète.

### 10.2 Equations

H¯ , la fonction de transfert du bloc peut être déterminée et étudiée grâce à une étude du circuit.
Ce bloc est parcouru par des signaux sinusoïdaux, il peut donc être décrit grâce aux équations phasorielles. Sur base des relations de Kirchhoff :

( V¯o−V¯i
R1

=

V¯ −V¯i
R2
V¯i−V¯
R3

= jωCV¯ ↔ V¯ =

V¯i
R3jωC+1

Dans notre cas R1=R2. on a donc V¯

o = V¯
i

·

1 − R3jωC
1 + R3jωC

H¯ =

V¯
o
V¯
i

=

1 − R3jωC
1 + R3jωC
Qu’on peut réécrire sous la forme

H¯ =

1 − j

ω
ω0
1 + j

ω
ω0

(14)

ω0 =

1
R3C

est la pulsation de coupure.

Sur base de (14), on peut étudier le comportement de H¯ (jω) en module et en phase et en déterminer le diagramme de Bode.

### 10.2.1 Module

Le module de H¯ (jω) peut s’exprimer selon l’équation suivante:

|H¯ (jω)| =

p
1 + (R3ωC)

2
p
1 + (R3ωC)

2

= 1 | (15)

Le module de H¯ ne varie donc pas avec la fréquence.

### 10.2.2 Phase

La phase de H¯ (jω) peut s’exprimer selon l’équation suivante:

Arg(H¯ (jω) = Arg(1 − R3jωC) − Arg(1 + R3jωC) | (16)

Arg(1-R3jω C) tend vers 0 pour des fréquences basses et -π/2 pour des fréquences hautes.

Arg(1+R3jω C) tend vers 0 pour des fréquences basses et +π/2 pour des fréquences hautes.

Arg(H¯ ) tend donc vers 0 pour des fréquences basses et -π pour des fréquences hautes.

La fréquence de coupure peut être déterminée grâce à (15):

ω0 = 2πf0 =

1
R3C

↔ f0 =

1
R3C2π

(17)

En remplaçant par les valeurs du circuit, f0 = 5.3kHz

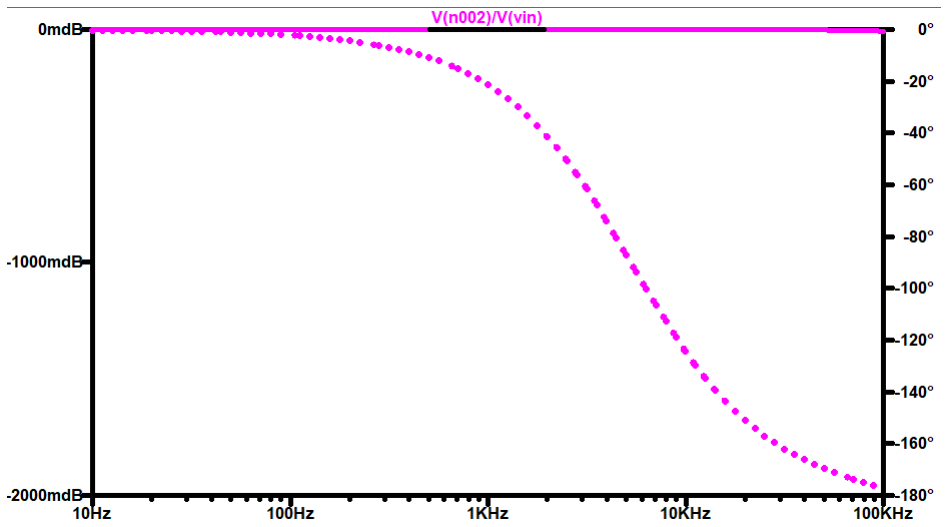
[picture p23: figure]

Figure 28: Diagramme de Bode du filtre passe-tout (simulation)

Le diagramme de Bode simulé grâce à LTspice est disponible à la figure 28. Il correspond en tout point à cette analyse, La courbe pleine représentant le module et la courbe pointillée la phase.

La relation entrée-sortie du bloc peut donc être décrite de la sorte:

Vout(t) = Vin(t − τ ) | (18)

où, selon notre dimensionnement, τ est le temps mis par le son pour parcourir la distance entre le micro et l’oreillette.

### 10.3 Choix des composants

Nous estimons la distance entre le tympan de l’utilisateur et le haut-parleur (∆x) à 2cm et souhaitons annuler parfaitement la fréquence 1000 Hz.
Le temps que met l’onde sonore pour passer du haut-parleur au tympan est ∆t =

∆x
v = 58 · 10⁻⁶
s ≈ 60µs
avec v la vitesse du son dans l’air sec(340 m/s).
Ce qui donne un déphasage ∆φ = ω∆t = 2πf∆t = 0.37[rad] = 21.2[degres] .
Le déphasage entre l’entrée et la sortie doit être négatif pour pouvoir avoir un retard et non une avance de Vout sur Vin, nous prenons dons −21.2[degres]. De plus, il n’est pas possible de faire un déphasage positif avec une capacité. En effet, une capacité ne peut que retarder la sortie par rapport à l’entrée.
Sur base de (16) :
Arg(H¯ (jω)) = arctan(

−R3ωC
1

) − arctan(

R3ωC
1

)

Arg(H¯ (jω)) = −2arctan(ωR3C)

Nous pouvons l’égaler au déphasage voulu pour obtenir les valeurs de C et R3.

ω∆t = −21.2 = −2arctan(ωR3C)

R3C1 = tan(

ωt
2

) ·

1
ω

= 29.75 · 10⁻⁶
(19)

d’où les valeurs R3 = 30kΩ et C1 = 1nF
Pour R3, nous utilisons un potentiomètre de 100kΩ pour pouvoir calibrer parfaitement le déphasage. Nous pouvons ainsi nous adapter à une autre fréquence que 1000Hz ou à une distance micro-oreillette différente.

### 10.4 Comparaison

### 10.4.1 Simulation

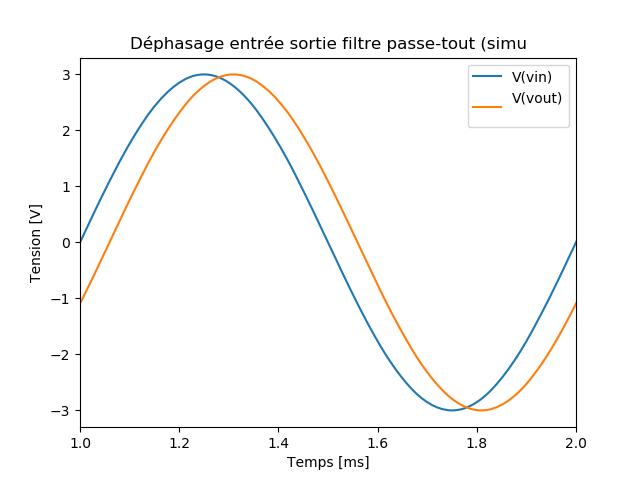
[picture p24: figure]

Figure 29: Déphasage entré sortie (simu)

Le circuit (figure 27) a été simulé grâce au logiciel Ltspice. On observe donc bien un déphasage entre l’entrée et la sortie (figure ??). Comme on peut le voir sur le diagramme de Bode (figure 28): pour une fréquence de 1kHz, le déphasage entre l’entrée et la sortie est bien de l’ordre de -20. Lors des mesures effectuées sur Ltspice le déphasage était de 21,45 et le retard de 59, 3µs pour une fréquence de 1kHz.

L’écart avec la théorie peut notamment s’expliquer par le fait que non avons arrondi 29,75 par 30 dans l’équation .

### 10.4.2 Résultat

Les mesures obtenues avec le MyDaq coïncident avec les simulations. Le décalage est bien de 60µs (figure 30) lorsque le potentiomètre (R3 sur la figure 27) est réglé sur 30kΩ et que le signal entrant est un sinus à 1kHz. De plus la fréquence mesurée sur le diagramme de Bode (figure 31) est bien de 5, 3kHz comme calculée dans la section 10.2.2 à l’équation 17

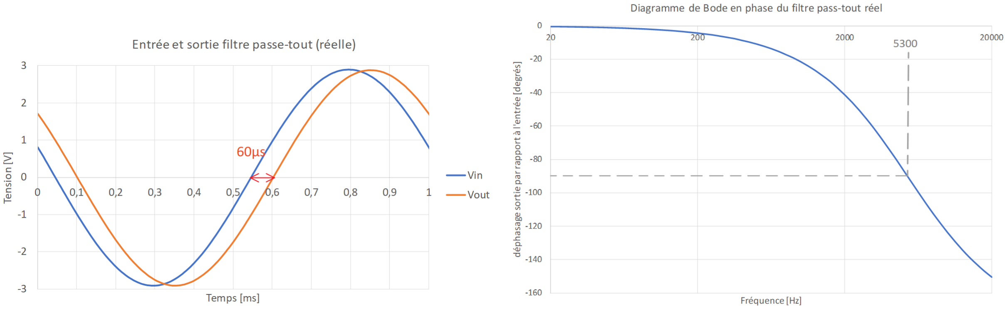
[picture p25: figure]

Figure 30: Déphasage entré sortie (réel) | Figure 31: Diagramme de Bode en phase du filtre passe-tout réel

## 11 Sommateur

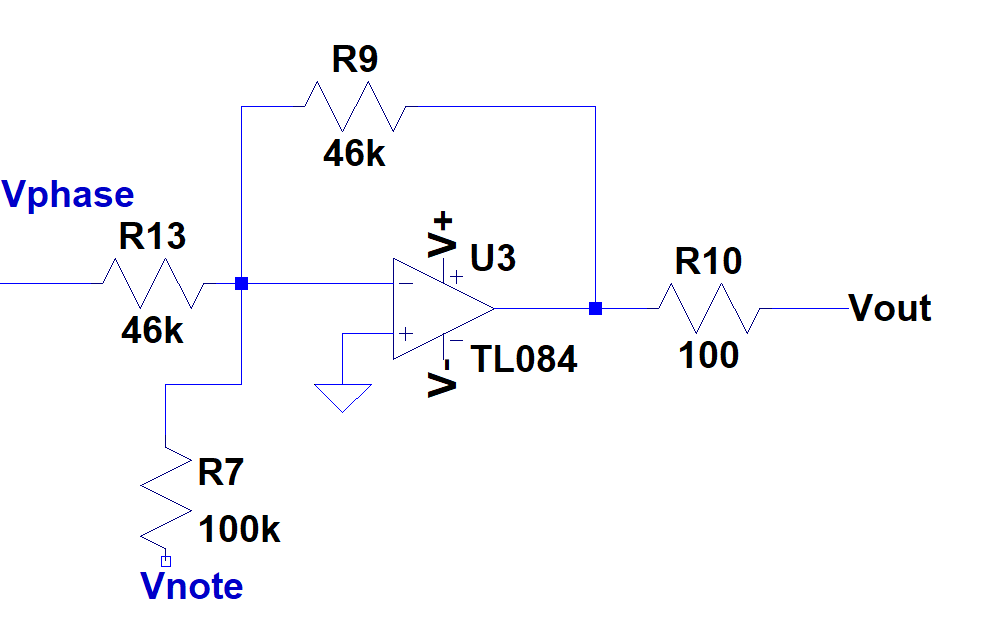
[picture p26: figure]

Figure 32: Circuit Sommateur

### 11.1 Description

Ce bloc (figure 33) a pour objectif de sommer le signal de sortie du filtre passe-tout et celui du conformateur et ensuite inverser cette somme. Le signal de sortie est ensuite envoyé au casque par l’intermédiaire d’une résistance variable (R10) permettant de limiter le courant.

### 11.2 Equations

Avec les lois de Kirchhoff:
Vphase

R13

+

Vnote
R7

=

−Vout
R9

Vout = −R9(

Vnote
R7

+

Vphase

R13

) | (20)

### 11.3 Choix des composants

Sur base de l’équation (20), on peut dimensionner les valeurs des résistances.
Le signal Vphase a une amplitude théorique de l’ordre du Volt alors que le signal Vphase a une amplitude d’environ 5V.

En jouant sur les résistances, on peut diminuer l’amplitude des tensions. Ainsi on peut diminuer l’impact de Vnote sur le signal final pour rendre l’impact de Vphase plus significatif. De plus, il ne faut pas faire varier l’amplitude de Vphase qui a une amplitude parfaitement calibrée pour annuler le son. Cette tension est calibrée à l’aide du potentiomètre de l’amplificateur section 9.
Sur base de cette analyse, les valeurs des résistances suivantes ont été imposées :
R7 = potentiomètre de 100kΩ permettant de régler l’amplitude de la composante de sortie provenant de Vnote R13 = 46kΩ
R9 = 46kΩ

## 12 Suiveur

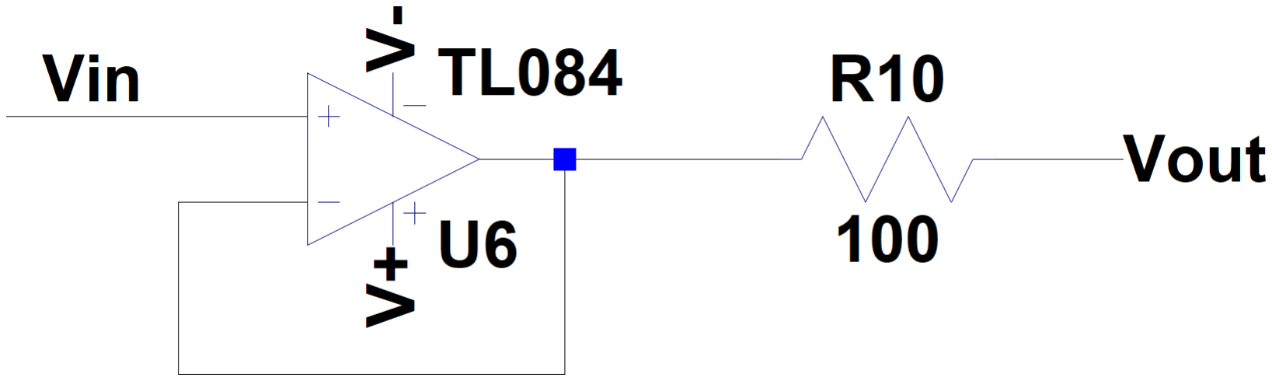
[picture p27: figure]

Figure 33: Circuit Suiveur

### 12.1 Description

Le but du suiveur est d’isoler l’impédance d’entrée et de sortie. Il permet d’alimenter le casque et d’éviter une chute de tension à la sortie du sommateur à cause du faible courant que celui-ci peut délivrer.
La résistance R10 est implémentée par un potentiomètre de 220ohm, faire varier cette résistance permet de faire varier le courant alimentant le casque et donc faire varier l’intensité du son.

### 12.2 Equations

Vout = Vin

## Part III

# Conclusion

Cette conclusion va reprendre le fonctionnement théorique global du circuit, comparer le résultat obtenu avec nos spécifications et enfin aborder des pistes d’amélioration et d’optimisation.

Synthétiseur Ce bloc est dimensionné pour produire la gamme des notes suivantes :LA3 → LA5, soit en couver-ture fréquentielle : 440Hz → 1760Hz.
L’enclenchement d’une combinaison d’interrupteurs permet d’avoir en sortie du clavier une tension continue com-mandable entre 1.5 et 6V selon la combinaison enclenchée. Ce signal rentre dans l’oscillateur contrôlé en tension (OCT) qui produit un signal triangulaire dont la fréquence est linéairement proportionnelle à la tension en sortie du clavier.
Ce signal triangulaire rentre enfin dans un conformateur à diodes qui le modifie en un signal dont la forme est proche d’un sinus en diminuant au maximum la valeur de l’amplitude pour toutes ses harmoniques hormis la fondamentale.

Noise-Cancelling Ce bloc a été dimensionné pour annuler parfaitement un signal monochromatique de 1000 Hz. Plus la fréquence du son diffère de cette valeur et plus le taux d’atténuation du dispositif diminue.
Le son à annuler rentre dans un micro qui le transforme en signal électrique. Ce signal passe ensuite dans un filtre passe-haut pour en enlever la composante DC et enfin dans un filtre passe-tout pour le déphaser.

Le tout rentre dans un sommateur-inverseur, ainsi la composante ”Noise-cancelling” du signal de sortie agit en interférence destructive avec le bruit à atténuer et l’utilisateur n’entend que le son venant du synthétiseur. Libre cours à votre imagination pour nous sustenter de vos plus belles compositions.

Critique La partie ”synthétiseur” répond parfaitement aux spécifications avec une différence maximale de fréquence en sortie du conformateur de 10Hz ou 0.5% sur les 2 octaves couvertes.
L’étude expérimentale du ”Noise-Cancelling” nous fait remarquer que les signaux sont parfaitement en accord avec la théorie : un signal monochromatique de 1000 Hz peut être atténué à plus de 99 % en théorie, plus la fréquence s’éloigne de cette valeur et plus le taux d’atténuation diminue.

Optimisation Globalement, nous sommes satisfaits du travail final et pensons qu’il respecte la majorité des objectifs fixés. Certains éléments peuvent être améliorés comme l’unité anti-bruit qui demande beaucoup de précision pour le calibrage de par la sensibilité du micro, ce qui la rend peu fonctionnelle. Il serait aussi possible d’augmenter le nombre d’octaves couvertes par le synthétiseur, mais cela demanderait une grande précision dans les valeurs des résistances choisies, cette précision étant dépendante des appareils de mesure utilisés. Dans notre cas une précision de l’ordre du mΩ nous a limité à l’implémentation de 2 octaves.

## Part IV

# Annexe

Ci-joint le tableau contenant toutes les valeurs de tensions à la sortie du clavier, les fréquences associées en sortie du synthétiseur, les résistances théoriques associées (Ri avec i ∈ [1, 13]) ainsi que les valeurs expérimentales, le δ entre ces 2 valeurs et le δ moyen.

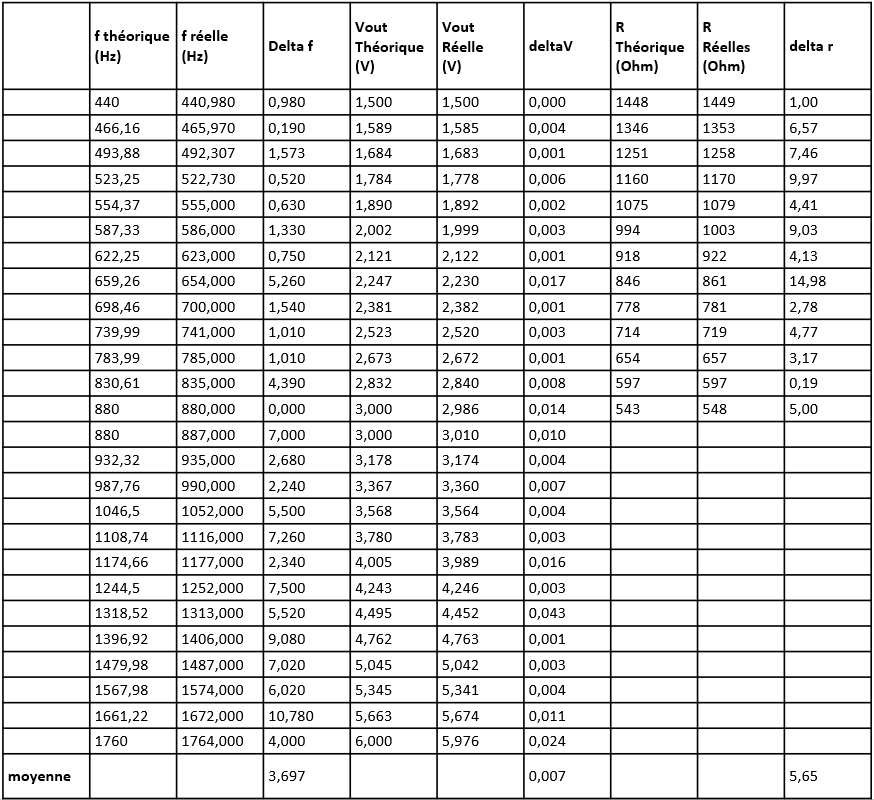
[picture p28: figure]

Figure 34: Tableau tension-fréquence-résistance

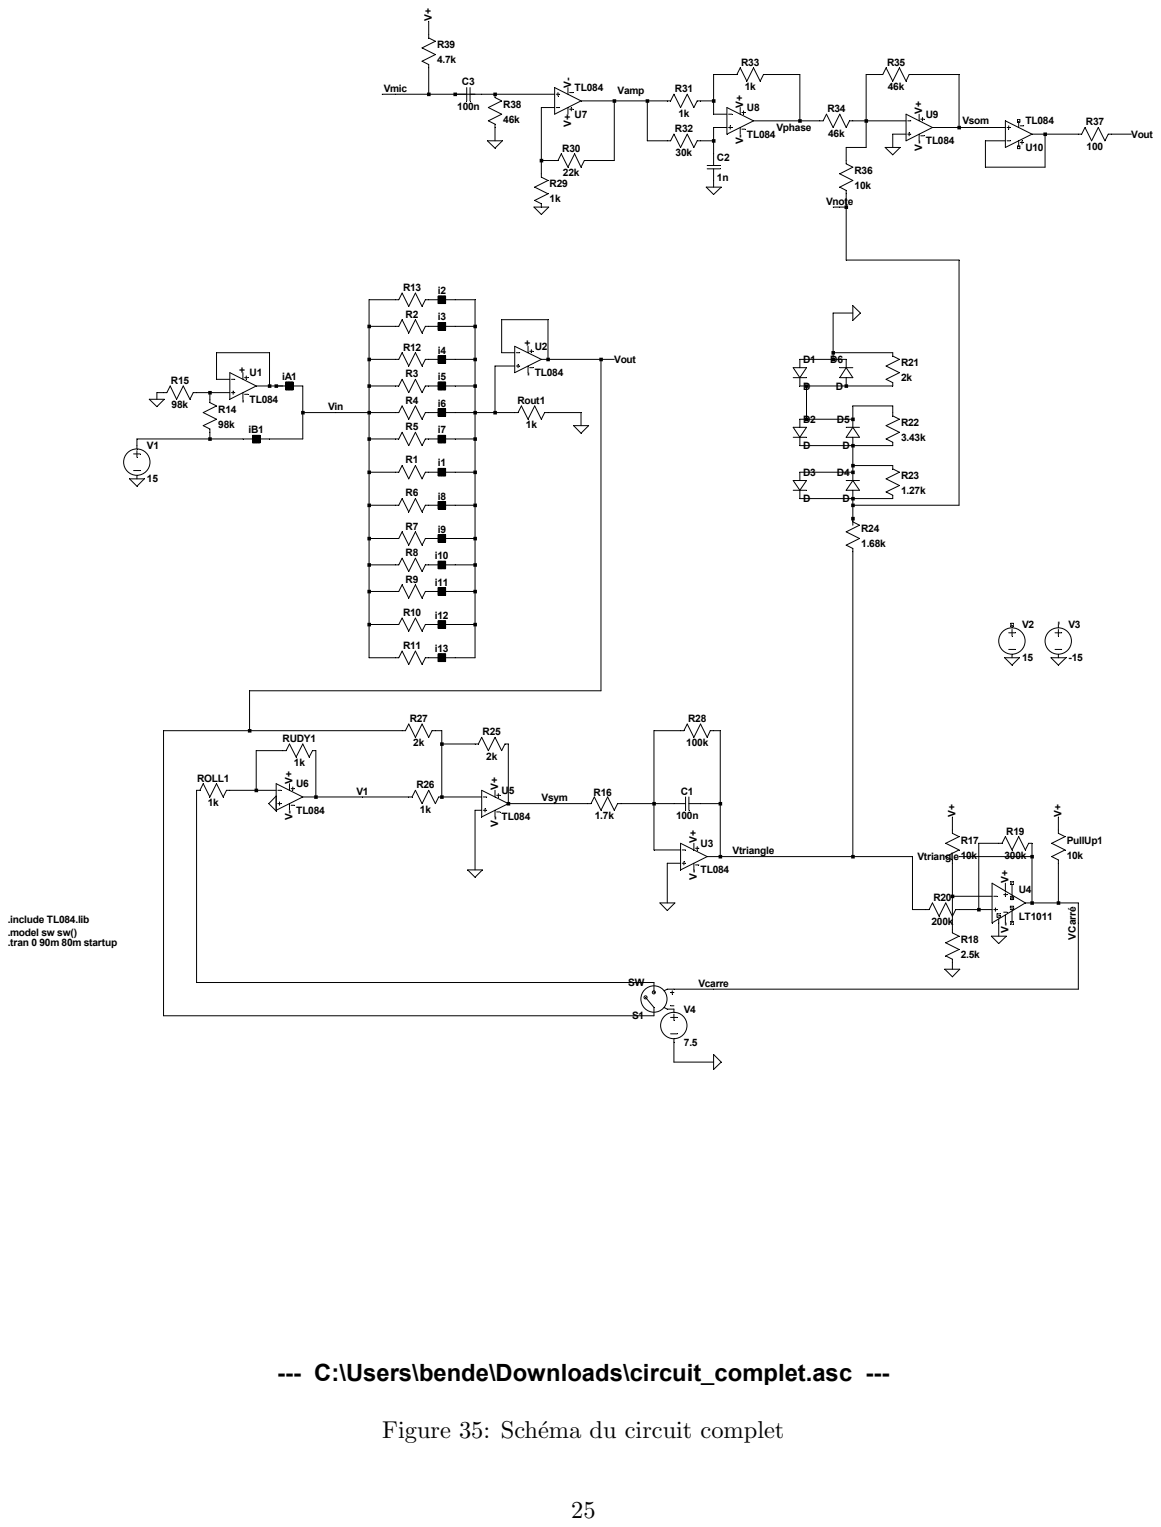
[picture p29: page 25]

--- C:\Users\bende\Downloads\circuit_complet.asc ---

Figure 35: Schéma du circuit complet
