delaitl/Synthetizer---Circuit-Architecture/LTSpice/Circuit.asc

C1: cap; 100n
C2: cap; 1n
C3: cap; 100n
D1: diode
D2: diode
D3: diode
D4: diode
D5: diode
D6: diode
i1: FerriteBead2
i2: FerriteBead2
i3: FerriteBead2
i4: FerriteBead2
i5: FerriteBead2
i6: FerriteBead2
i7: FerriteBead2
i8: FerriteBead2
i9: FerriteBead2
i10: FerriteBead2
i11: FerriteBead2
i12: FerriteBead2
i13: FerriteBead2
iA1: FerriteBead2
iB1: FerriteBead2
PullUp1: res; 10k
R1: res; ""
R2: res; ""
R3: res; ""
R4: res; ""
R5: res; ""
R6: res; ""
R7: res; ""
R8: res; ""
R9: res; ""
R10: res; ""
R11: res; ""
R12: res; ""
R13: res; ""
R14: res; 98k
R15: res; 98k
R16: res; 1.7k
R17: res; 10k
R18: res; 2.5k
R19: res; 300k
R20: res; 200k
R21: res; 2k
R22: res; 3.43k
R23: res; 1.27k
R24: res; 1.68k
R25: res; 2k
R26: res; 1k
R27: res; 2k
R28: res; 100k
R29: res; 1k
R30: res; 22k
R31: res; 1k
R32: res; 30k
R33: res; 1k
R34: res; 46k
R35: res; 46k
R36: res; 10k
R37: res; 100
R38: res; 46k
R39: res; 4.7k
ROLL1: res; 1k
Rout1: res; 1k
RUDY1: res; 1k
S1: sw
U1: opamp2; TL084
U2: opamp2; TL084
U3: opamp2; TL084
U4: LT1011
U5: opamp2; TL084
U6: opamp2; TL084
U7: opamp2; TL084
U8: opamp2; TL084
U9: opamp2; TL084
U10: opamp2; TL084
V1: voltage; 15
V2: voltage; 15
V3: voltage; -15
V4: voltage; 7.5
Named nets: 0, Vout, +, -, Vin, V+, V-, Vtriangle, Vcarre, V1, Vsym, Vmic, Vnote, VCarré
.include TL084.lib
.tran 0 90m 80m startup
.model sw sw()
Vamp
Vphase
Vsom
